BelaPlatform/embelashed-hardware/Pocket-connectors/pocket-connector-analog/BOM/pocket-connector-bom.csv

Component Count: | 1
Individual Components:
Item | Qty | Reference(s) | Value | Brand | Part number | Link
 |  | J1 | Grove_4x2mm | Seeed Studio | 110990037 | https://uk.rs-online.com/web/p/semiconductor-development-kit-accessories/1793715/
Collated Components:
Item | Qty | Reference(s) | Value |  | Part number | Link
1 | 1 | J1 | Grove_4x2mm | Seeed Studio | 110990037 | https://uk.rs-online.com/web/p/semiconductor-development-kit-accessories/1793715/
