BelaPlatform/embelashed-hardware/Capelets/bela_paper_capelet/bela_paper_capelet.kicad_pcb

## KiCad design Capelets/bela_paper_capelet/bela_paper_capelet.kicad_pcb (2019-05-30)

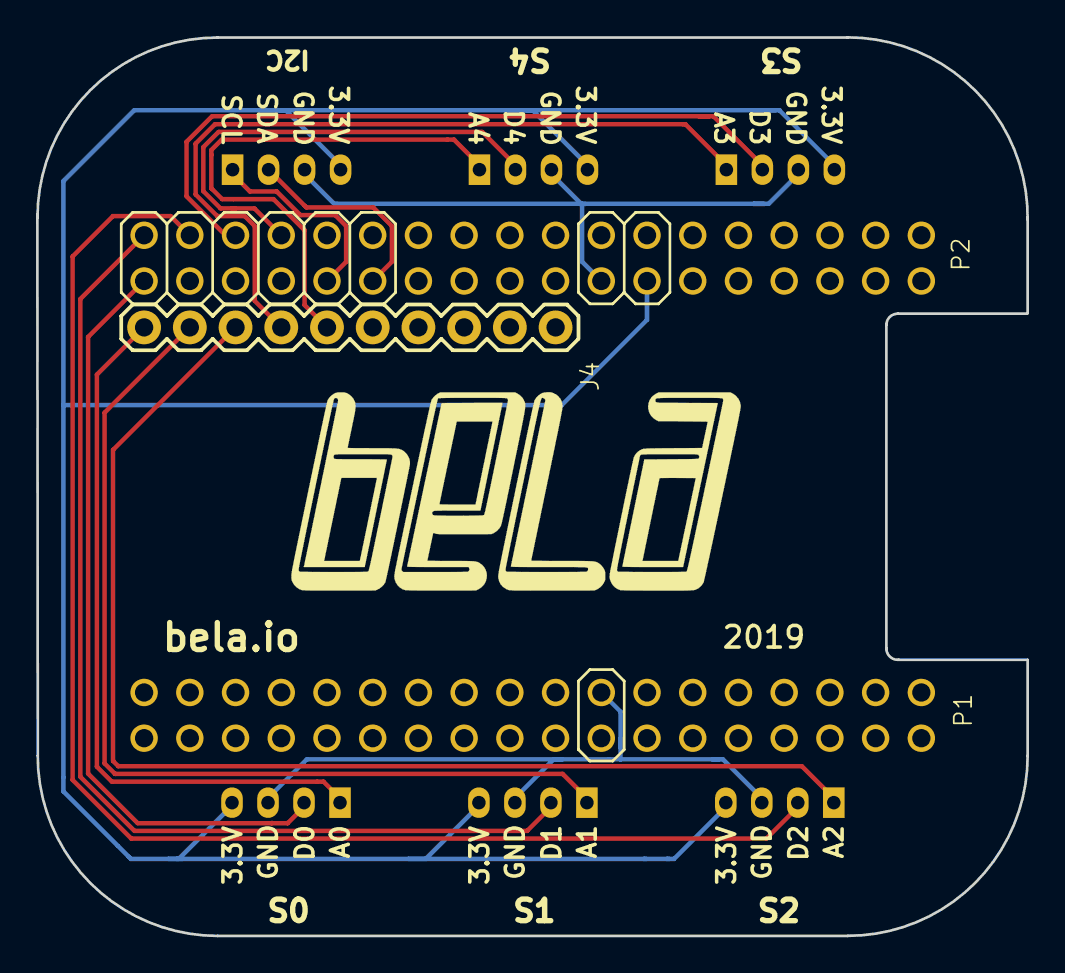
[picture p1: board bela_paper_capelet.kicad_pcb from above]

Board: 2 copper layers, 55.0 x 49.9 mm, 9 parts (0 on the bottom side), 14 nets.

Parts:
J1, J2, J3, J5, J6, J7: Grove_4x2mm; JST_PH_S4B-PH-K_04x2.00mm_Angled
J4: M10SILK_FEMALE_PTH; 1X10
P1: PINHD-2X18; 2X18_P1
P2: PINHD-2X18; 2X18_P2

Connections:
+3V3: J1.4, J2.4, J3.4, J5.4, J6.4, J7.4
/A0: J4.10, J5.1
/A1: J4.9, J6.1
/A2: J4.8, J7.1
/A3: J3.1, J4.7
/A4: J2.1, J4.6
/D0: J5.2, P2.1
/D1: J6.2, P2.2
/D2: J7.2, P2.4
/D3: J3.2, P2.6
/D4: J2.2, P2.8
/SCL: J1.1, P2.9
/SDA: J1.2, P2.11
GND: J1.3, J2.3, J3.3, J4.2, J5.3, J6.3, J7.3, P1.16, P1.22, P2.15, P2.21
